petrohi/terminal/README.md

# Geoff's VT100 Terminal

DIY kit including parts and PCB is available on [Tindie](https://www.tindie.com/products/petrohi/geoffs-vt100-terminal-kit/).

## Use PICKit4 to flash the PIC32

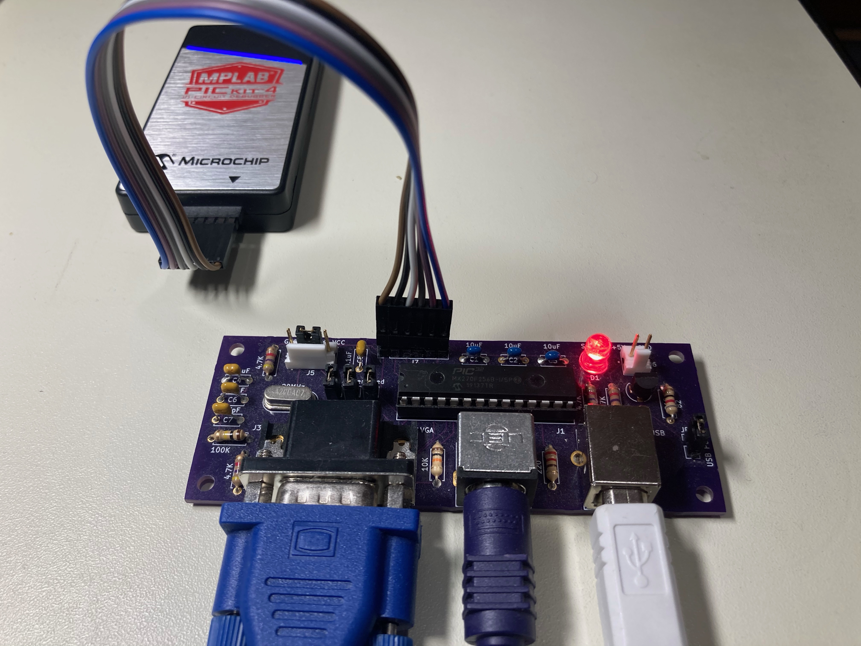
[picture p1: doc/PICKit4.jpeg]
PICKit4


## Use a Raspberry Pi to flash the PIC32

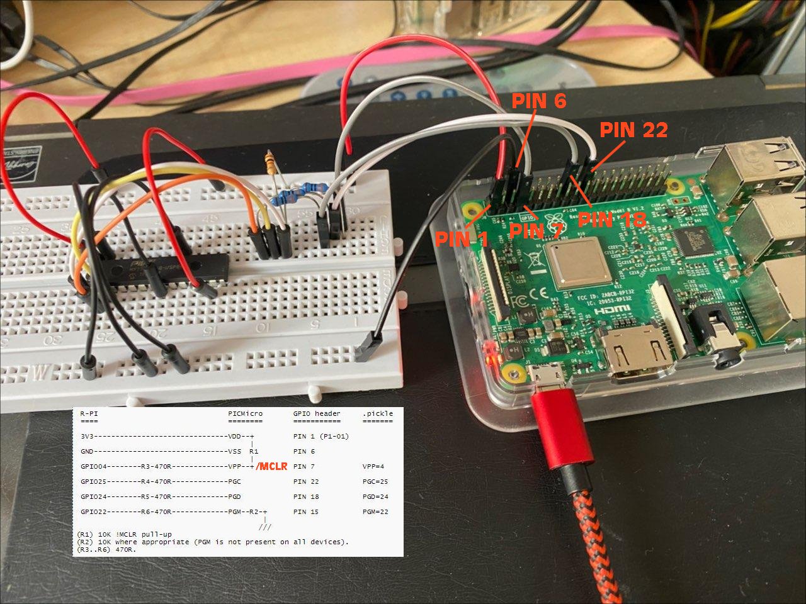
[picture p2: doc/RasberryPi_programmer.jpg]
RasberryPi Programmer


### How to program a PIC Microcontroller using a Raspberry Pi or Orange Pi

* [Pickle](https://www.pedalpc.com/blog/program-pic-raspberry-pi/)
* [Raspberry Pi Setup](https://wiki.kewl.org/dokuwiki/boards:rpi)
