petrohi/terminal/doc/terminal_packing_list.odt

Packing List

| 2 layer PCB
| PIC32MX270F256B-I/SP-ND microcontroller preprogrammed with firmware
| MCP1700-3302E/TO-ND voltage regulator
| Red LED
| 20MHz Crystal
| Sobertone GT-0603A-2 Buzzer
| Ceramic Capacitors 27pF 50V (2)
| Ceramic Capacitors 0.1uF 50V (2)
| Ceramic Capacitors 10uF 16V (3)
| Resistor 82Ω
| Resistor 220Ω
| Resistors 4.7KΩ (4)
| Resistor 10KΩ
| Resistor 100KΩ
| USB B Type Socket
| DE-15 Female Connector
| 6 Pin Mini DIN Female Connector
| 4 way Header Connector
| 2 way Header Connector
| DIP socket
| Header Pins (16)
| Jumpers (4)
