petrohi/terminal/doc/BOM.md

# BOM

| Qty | Component | Digi-Key Part # |
|--|--|--|
| 1 | 2 layer PCB | |
| 1 | PIC32MX270F256B-I/SP-ND microcontroller | [PIC32MX270F256B-I/SP-ND](https://www.digikey.com/en/products/detail/microchip-technology/PIC32MX270F256B-I-SP/4902630) |
| 1 | MCP1700-3302E/TO-ND voltage regulator | [MCP1700-3302E/TO-ND](https://www.digikey.com/en/products/detail/microchip-technology/MCP1700-3302E-TO/652680) |
| 1 | Red LED | [C503B-RAN-CZ0C0AA2CT-ND](https://www.digikey.com/en/products/detail/creeled-inc/C503B-RAN-CZ0C0AA2/6561762) |
| 1 | 20MHz Crystal | [535-9046-ND](https://www.digikey.com/en/products/detail/abracon-llc/ABL-20-000MHZ-B2/675241) |
| 1 | Sobertone GT-0603A-2 Buzzer | [433-1193-ND](https://www.digikey.com/en/products/detail/soberton-inc/GT-0603A-2/8600790) |
| 2 | Ceramic Capacitors 27pF 50V | [BC1006CT-ND](https://www.digikey.com/en/products/detail/vishay-beyschlag-draloric-bc-components/K270J15C0GF5TL2/286460) |
| 2 | Ceramic Capacitors 0.1uF 50V | [BC1084CT-ND](https://www.digikey.com/en/products/detail/vishay-beyschlag-draloric-bc-components/K104K15X7RF5TL2/286538) |
| 3 | Ceramic Capacitors 10uF 16V | [445-FK24X5R1C106KR000-ND](https://www.digikey.com/en/products/detail/tdk-corporation/FK24X5R1C106KR000/2815427) |
| 1 | Resistor 82Ω | [CF14JT82R0CT-ND](https://www.digikey.com/en/products/detail/stackpole-electronics-inc/CF14JT82R0/1741513) |
| 1 | Resistor 220Ω | [CF14JT220RCT-ND](https://www.digikey.com/en/products/detail/stackpole-electronics-inc/CF14JT220R/1741346) |
| 4 | Resistors 4.7KΩ (4) | [CF14JT4K70CT-ND](https://www.digikey.com/en/products/detail/stackpole-electronics-inc/CF14JT4K70/1741428) |
| 1 | Resistor 10KΩ | [CF14JT10K0CT-ND](https://www.digikey.com/en/products/detail/stackpole-electronics-inc/CF14JT10K0/1741265) |
| 1 | Resistor 100KΩ | [CF14JT100KCT-ND](https://www.digikey.com/en/products/detail/stackpole-electronics-inc/CF14JT100K/1741263) |
| 1 | USB B Type Socket | [102-5888-ND](https://www.digikey.com/en/products/detail/cui-devices/UJ2-BH-W4-TH/6188078) |
| 1 | DE-15 Female Connector | [L77HDE15SD1CH4F-ND](https://www.digikey.com/en/products/detail/amphenol-cs-commercial-products/L77HDE15SD1CH4F/4888523) |
| 1 | 6 Pin Mini DIN Female Connector | [CP-2260-ND](https://www.digikey.com/en/products/detail/cui-devices/MD-60SM/96940) |
| 1 | 4 way Header Connector | [A30788-ND](https://www.digikey.com/en/products/detail/te-connectivity-amp-connectors/3-641215-4/765872) |
| 1 | 2 way Header Connector | [A24932-ND](https://www.digikey.com/en/products/detail/te-connectivity-amp-connectors/641215-2/331087) |
| 1 | DIP socket | [ED3050-5-ND](https://www.digikey.com/en/products/detail/on-shore-technology-inc/ED281DT/4147600) |
| 16 | Header Pins | [S1011EC-32-ND](https://www.digikey.com/en/products/detail/sullins-connector-solutions/PRPC032SAAN-RC/2775222) |
| 4 | Jumpers | [S9337-ND](https://www.digikey.com/en/products/detail/sullins-connector-solutions/QPC02SXGN-RC/2618262) |
