petrohi/terminal/case/Cover1.stl

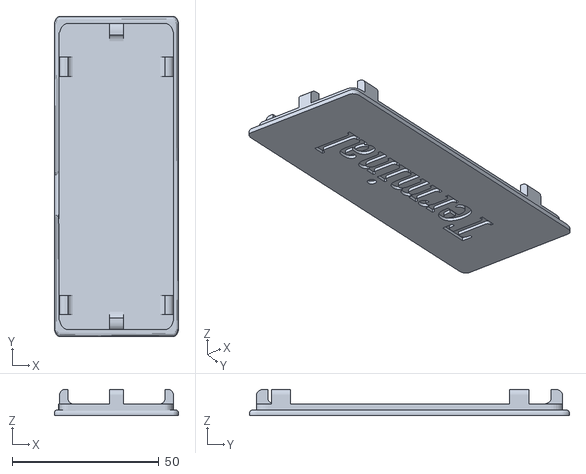
[picture p3: CAD file, 2020-11-10]
case/Cover1.stl
42.3 x 109.0 x 9.00
