petrohi/terminal/kicad/terminal/3d/CUI_MD-60SM.step

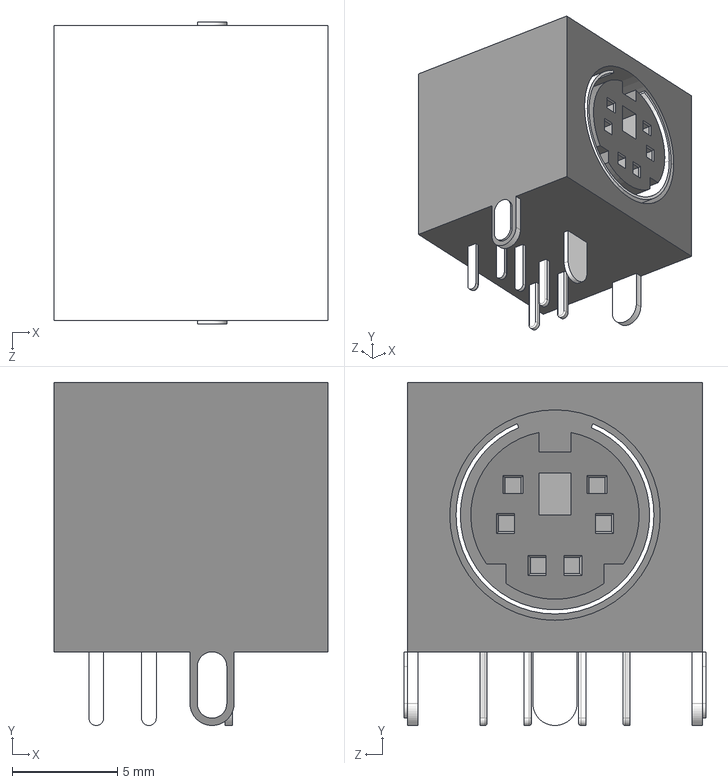
[picture p5: CAD file, 2019-12-02]
kicad/terminal/3d/CUI_MD-60SM.step
13.0 x 16.3 x 14.3 mm
