petrohi/terminal/case/Terminal Box.stl

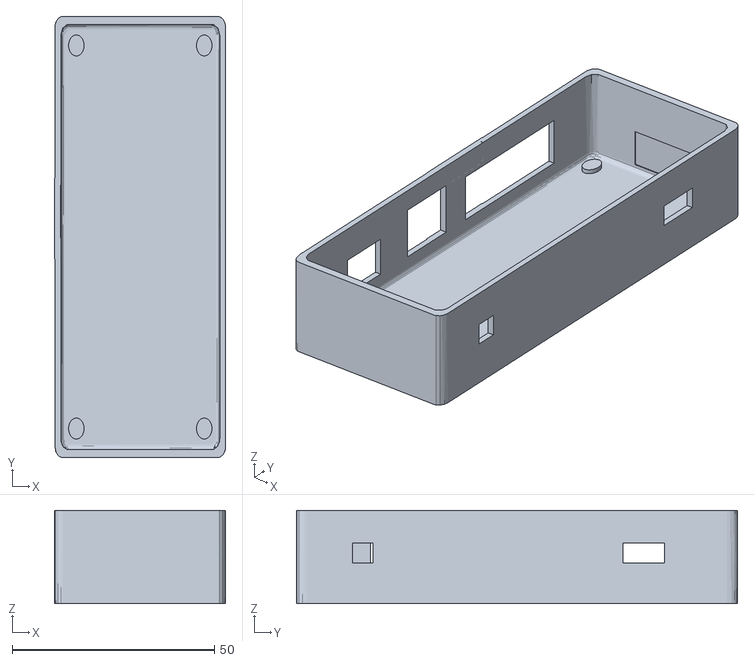
[picture p6: CAD file, 2020-11-10]
case/Terminal Box.stl
42.3 x 109.0 x 23.0
