petrohi/terminal/kicad/terminal/3d/c-3-641215-2-z-3d.stp

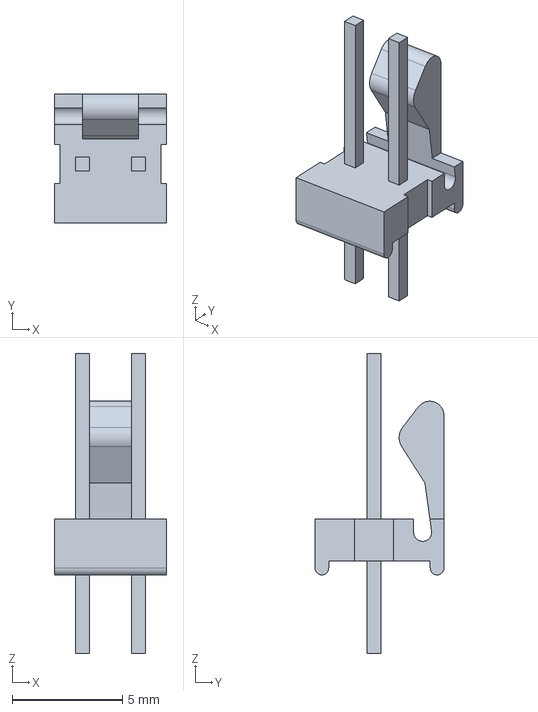
[picture p7: CAD file, 2019-12-02]
kicad/terminal/3d/c-3-641215-2-z-3d.stp
5.08 x 5.84 x 13.6 mm
