petrohi/terminal/(list of files, cad)

Other CAD files:
case/Cover2.stl
