petrohi/terminal/(threads)

Thread 23 (2021-05-25):

usb keyboard

bkw777, 2021-05-25:
Is it at all possible to incorporate @dhansel 's usb keyboard change?
https://github.com/dhansel/TerminalUSB

I have made a pcb that started like yours, dropped the PS/2 port, switched the usb port to type B, added a barrel power jack, and optimized the traces a little.
https://github.com/bkw777/Geoff_vt100
...in hopes I could maybe figure out the differences dhansel made to the original Geoff firmware, and then apply them to yours, which I have not done.

Thread 36 (2023-03-14):

Can we convert an original Geoff Graham ASCII Video Terminal to use this firmware?

BRFud, 2023-03-14:
Hi, and thanks for creating this project. I have a an original Geoff Graham ASCII Video Terminal (originally purchased from Silicon Chip magazine) and would like to know what steps are needed to modify my unit to support this firmware? Do you know if it is possible and could you give me a start by listing the hardware modifications required? Geoff's website lists only that it uses a different crystal, though I notice you have also added a buzzer. Is there anything else? Thank you.

BRFud, 2023-03-24:
closing as I have now recieved some boards to build the terminal version in this repo.

Closed 2023-03-24.

Thread 37 (2023-12-12):

IRQ

Wawavoun, 2023-12-12:
Hi,

On some multitasking system the irq pin of the serial interface chip (MC6850 fe) need to be used.
Polling is not an option.

On MC6850 this pin only works if a kind of flow control (rts/cts) is activated.

The serial link to your terminal has not this option.
Of course this will need to change destination of two pins but may be it is possible to disable some functions (buzzer ?) to get this.

May be in a future version ?

Thanks and regards.
Philippe

Thread 38 (2024-02-14):

PS/2 to USB adapter leads to PS/2 Keyboard not detected

oilcan-productions, 2024-02-14:
I ordered these https://a.co/d/gUzlF0a to hook up a USB keyboard to the VT 100.
Unfortunately it seems it is not detecting the keyboard I use https://a.co/d/cD3fbKI or any other USB keyboard for that matter.

Anything I can do to help with that?

sswazey, 2024-11-22:
Sorry that device won't work.  It's a passive device that just converts the connection.  It expects an older USB keyboard that has legacy PS/2 mode.  The older USB keyboard detects that USB is not connected and then switches to the PS/2 signals.  Almost all of the modern USB keyboards have abandoned PS/2 compatibility mode.
