petrohi/terminal/doc/schematic.pdf

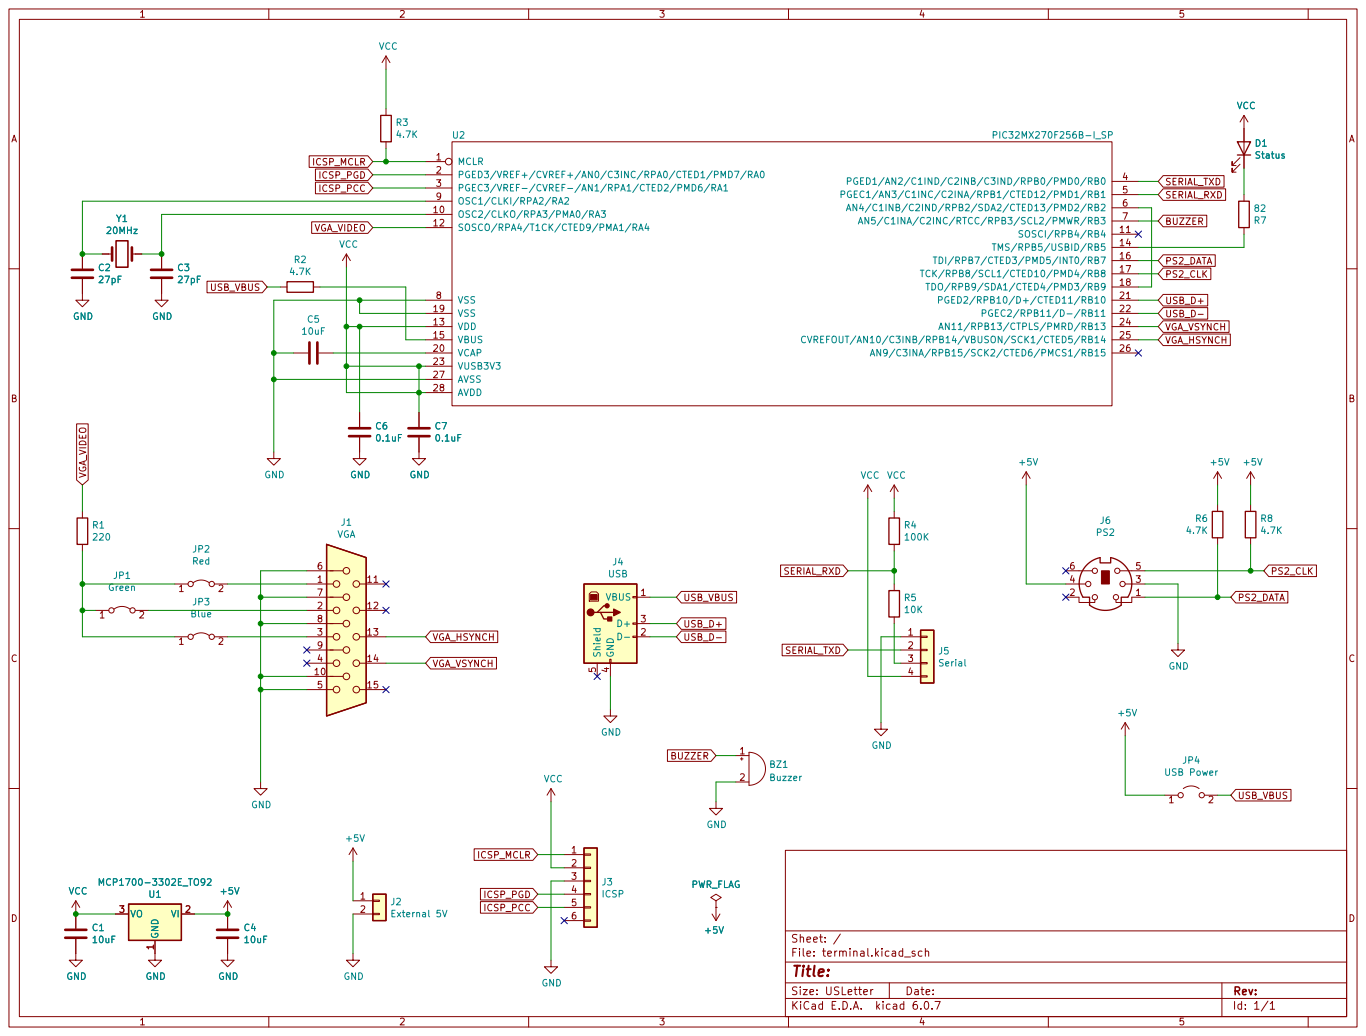
[picture p8: page 1]

1 VI 2 VO 3 U1 MCP1700-3302E_TO92 VCC GND
