petrohi/terminal/firmware/Terminal.X/terminal.c

#include "terminal_internal.h"

#define PRODUCT_NAME                                                           \
  "\33[1;91mA\33[92mS\33[93mC\33[94mI\33[95mI\33[39m Terminal\33[m\r\n"
#define PRODUCT_VERSION "Version 3.2.0\r\n"
#ifdef TERMINAL_8BIT_COLOR
#define PRODUCT_COPYRIGHT                                                      \
  "Copyright (C) 2019-2020 Peter Hizalev\r\n"                                  \
  "https://github.com/petrohi/ascii_terminal\r\n"
#else
#define PRODUCT_COPYRIGHT                                                      \
  "Copyright (C) 2019-2022 Peter Hizalev\r\n"                                  \
  "Copyright (C) 2014 Geoff Graham\r\n"                                        \
  "Copyright (C) 2020 Birko Bergt (DL8BB)\r\n"                                 \
  "Copyright (C) 2021 Stefan \"Blixten\" Karlsson\r\n"                         \
  "https://github.com/petrohi/terminal\r\n"
#endif
#define PRODUCT_HELP "\r\nPress CTRL+ALT+DEL to enter SETUP\r\n"

void terminal_timer_tick(struct terminal *terminal) {
  terminal_keyboard_update_repeat_counter(terminal);
  terminal_screen_update_cursor_counter(terminal);
  terminal_screen_update_blink_counter(terminal);
}

void terminal_init(struct terminal *terminal,
                   const struct terminal_callbacks *callbacks,
                   struct visual_cell *default_cells,
#ifdef TERMINAL_ALT_CELLS
                   struct visual_cell *alt_cells,
#endif
                   uint8_t *tab_stops, size_t tab_stops_size,
                   const volatile struct terminal_config *config,
                   character_t *transmit_buffer, size_t transmit_buffer_size) {
  terminal->callbacks = callbacks;
  terminal->default_cells = default_cells;
#ifdef TERMINAL_ALT_CELLS
  terminal->alt_cells = alt_cells;
#endif
  terminal->tab_stops = tab_stops;
  terminal->tab_stops_size = tab_stops_size;

  switch (config->format_rows) {
  case FORMAT_24_ROWS:
    terminal->format.rows = 24;
    break;
  case FORMAT_30_ROWS:
    terminal->format.rows = 30;
    break;
  }

  terminal->format.cols = 80;
#ifndef TERMINAL_8BIT_COLOR
  terminal->monochrome_transform = config->monochrome_transform;
#endif
  terminal->transmit_buffer = transmit_buffer;
  terminal->transmit_buffer_size = transmit_buffer_size;
  terminal->transmit_buffer_head = 0;

  terminal->charset = config->charset;
  terminal->keyboard_compatibility = config->keyboard_compatibility;
  terminal->receive_c1_mode = config->receive_c1_mode;
  terminal->transmit_c1_mode = config->transmit_c1_mode;

  terminal->auto_wrap_mode = config->auto_wrap_mode;
  terminal->scrolling_mode = false;
  terminal->column_mode = false;
  terminal->screen_mode = config->screen_mode;
  terminal->origin_mode = false;
  terminal->insert_mode = false;

  terminal->send_receive_mode = config->send_receive_mode;

  terminal->new_line_mode = config->new_line_mode;
  terminal->cursor_key_mode = config->cursor_key_mode;
  terminal->keyboard_action_mode = false;
  terminal->auto_repeat_mode = config->auto_repeat_mode;
  terminal->ansi_mode = config->ansi_mode;
  terminal->backspace_mode = config->backspace_mode;

  terminal->flow_control = config->flow_control;
  terminal->bell_buzzer = config->bell_buzzer;

  terminal->lock_state.caps = 0;
  terminal->lock_state.scroll = 0;
  terminal->lock_state.num = config->application_keypad_mode ? 0 : 1;

  terminal_keyboard_init(terminal, config->keyboard_layout);
  terminal_screen_init(terminal);
  terminal_uart_init(terminal);

  terminal->saved_vs = terminal->vs;

  switch (config->start_up) {
  case START_UP_NONE:
    break;
  case START_UP_MESSAGE:
    terminal_uart_receive_string(
        terminal,
        PRODUCT_NAME PRODUCT_VERSION PRODUCT_COPYRIGHT PRODUCT_HELP "\r\n");
    break;
#ifdef TERMINAL_8BIT_COLOR
  case START_UP_TEST_COLOR1:
    terminal->callbacks->screen_test(terminal->format, SCREEN_TEST_COLOR1);
    break;
  case START_UP_TEST_COLOR2:
    terminal->callbacks->screen_test(terminal->format, SCREEN_TEST_COLOR2);
    break;
#endif
  case START_UP_TEST_FONT1:
    terminal->callbacks->screen_test(terminal->format, SCREEN_TEST_FONT1);
    break;
  case START_UP_TEST_FONT2:
    terminal->callbacks->screen_test(terminal->format, SCREEN_TEST_FONT2);
    break;
  }

  terminal_uart_receive_string(terminal, "\x07");
}
