petrohi/terminal/firmware/Terminal.X/bold.h

/* row data, big-endian (smallest bit on right) */

const int bold_font_glyphs = 1199;
const int bold_font_height = 16;

const uint8_t bold_font_data[19184] = {
  0x00, 0x00, 0xee, 0xc6, 0x00, 0xc6, 0xc6, 0xc6, 0x00, 0xc6, 0xc6, 0xee, 0x00, 0x00, 0x00, 0x00, 
  0x00, 0x00, 0x00, 0x00, 0x00, 0x00, 0x00, 0x00, 0x00, 0x00, 0x00, 0x00, 0x00, 0x00, 0x00, 0x00, 
  0x00, 0x00, 0x18, 0x18, 0x18, 0x18, 0x18, 0x18, 0x18, 0x00, 0x18, 0x18, 0x00, 0x00, 0x00, 0x00, 
  0x00, 0x66, 0x66, 0x66, 0x00, 0x00, 0x00, 0x00, 0x00, 0x00, 0x00, 0x00, 0x00, 0x00, 0x00, 0x00, 
  0x00, 0x00, 0x6c, 0x6c, 0x6c, 0xfe, 0x6c, 0x6c, 0xfe, 0x6c, 0x6c, 0x6c, 0x00, 0x00, 0x00, 0x00, 
  0x00, 0x10, 0x10, 0x7c, 0xd6, 0xd0, 0xd0, 0x7c, 0x16, 0x16, 0xd6, 0x7c, 0x10, 0x10, 0x00, 0x00, /* 5 */
  0x00, 0x00, 0x66, 0xd6, 0x6c, 0x0c, 0x18, 0x18, 0x30, 0x36, 0x6b, 0x66, 0x00, 0x00, 0x00, 0x00, 
  0x00, 0x00, 0x38, 0x6c, 0x6c, 0x38, 0x76, 0xdc, 0xcc, 0xcc, 0xdc, 0x76, 0x00, 0x00, 0x00, 0x00, 
  0x00, 0x18, 0x18, 0x18, 0x00, 0x00, 0x00, 0x00, 0x00, 0x00, 0x00, 0x00, 0x00, 0x00, 0x00, 0x00, 
  0x00, 0x00, 0x0c, 0x18, 0x30, 0x30, 0x30, 0x30, 0x30, 0x30, 0x18, 0x0c, 0x00, 0x00, 0x00, 0x00, 
  0x00, 0x00, 0x30, 0x18, 0x0c, 0x0c, 0x0c, 0x0c, 0x0c, 0x0c, 0x18, 0x30, 0x00, 0x00, 0x00, 0x00, /* 10 */
  0x00, 0x00, 0x00, 0x00, 0x00, 0x6c, 0x38, 0xfe, 0x38, 0x6c, 0x00, 0x00, 0x00, 0x00, 0x00, 0x00, 
  0x00, 0x00, 0x00, 0x00, 0x00, 0x18, 0x18, 0x7e, 0x18, 0x18, 0x00, 0x00, 0x00, 0x00, 0x00, 0x00, 
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
, 1065, 1066, 1067, 1068, 1069, 1070, 1071, 1072, 1073, 1074, 1075, 1076, 1077, 1078, 1079, 1080, 1081, 1082, 1083, 1084, 1085, 1086, 1087, 1088, 1089, 1090, 1091, 1092, 1093, 1094, 1095, 1096, 1097, 1098, 1099, 1100, 1101, 1102, 1103, 1104, 1105, 1106, 1107, 1108, 1109, 1110, 1111, 1112, 1113, 1114, 1115, 1116, 1117, 1118, 1119, 1120, 1121, 1122, 1123, 1124, 1125, 1126, 1127, 1128, 1129, 1130, 1131, 1132, 1133, 1134, 1135, 1136, 1137, 1138, 1139, 1140, 1141, 1142, 1143, 1144, 1145, 1146, 1147, 1148, 1149, 1150, 1151, 1152, 1153, 1154, 1155, 1156, 1157, 1158, 1159, 1160, 1161, 1162, 1163, 1164, 1165, 1166, 1167, 1168, 1169, 1170, 1171, 1172, 1173, 1174, 1175, 1176, 1177, 1178, 1179, 1180, 1181, 1182, 1183, 1184, 1185, 1186, 1187, 1188, 1189, 1190, 1191, 1192, 1193, 1194, 1195, 1196, 1197, 351, 1198 };
