petrohi/terminal/firmware/Terminal.X/luminance_table.h

#define LUMNINANCE_TABLE_SIZE 256

static const uint8_t luminance_table[LUMNINANCE_TABLE_SIZE] = {
  0,
  27,
  91,
  118,
  9,
  36,
  100,
  192,
  128,
  54,
  182,
  236,
  18,
  72,
  200,
  254,
  0,
  6,
  9,
  12,
  15,
  18,
  67,
  74,
  77,
  80,
  83,
  86,
  96,
  103,
  106,
  109,
  112,
  114,
  125,
  132,
  134,
  137,
  140,
  143,
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
};
