petrohi/terminal/(commit log)

2019-10-13 KiCad files
    [terminal.kicad_pcb, terminal.sch]
2019-10-16 Move KiCad files
    [terminal.kicad_pcb, terminal.sch]
2019-10-30 Use oval holes instead of cuts in footprints. Remove bootload jumper.
    [terminal.kicad_pcb, terminal.sch]
2019-12-02 Vga (#1)
    * VGA firmware
    * VGA hardware
    * Fix serial pin marks
    * Remove old video
    * 3D models
    * Adjust copyright notes
    * Move and rename VGA constants
    * Adjust name in prompt
    * VT escape commands
    * HS mode for primary oscillator
    * Enlarge serial and USB buffers
    * Simple graphics
    * 20MHz crystal to support USB
    * Adjust USB and serial buffers
    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
    [CUI_MD-60SM.step, c-3-641215-2-z-3d.stp, c-3-641215-4-z-3d.stp, terminal.kicad_pcb, terminal.sch]
2020-09-24 Port version 3 firmware (#15)
    * Port version 3 firmware
    * Convert PS/2 scancode to USB HID info
    * Simplified VGA driver
    * One DMA transfer per frame
    * Byte-aligned VGA buffer
    * Monochrome configuration
    * Constant luminance table
    * Yield to probe keyboard
    * Fix keyboard LEDs
    * Clear screen line for monochrome
    * Use local buffer for echo mode
    * Fix SD/SU
    * Probe keyboard when in config UI
    * Optimize character rendering
    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
    [terminal.kicad_pcb, terminal.sch]
2020-11-10 Added a 3d printable case
    [Cover1.stl, Cover2.stl, Terminal Box.stl]
2020-11-10 Fixed stupid naming problem
    [Cover1.stl, Terminal Box.stl]
2021-05-11 Fix "warning: Interrupt priority IPLx is deprecated"
    [keyboard.c, main.c]
2021-11-21 Fix default tab positions to match VT100 Technical Manual, Third Edition, July 1982
    [terminal_screen.c]
2021-12-14 Fix for buffer head changing while receiving in the main loop
    [main.c]
2021-12-25 Fix missing key press
    [keyboard.c]
2022-06-07 Improved PCB
    [terminal.kicad_pcb, terminal.kicad_sch, terminal.sch]
2022-06-07 Remove volatile const workaround
    [main.c]
2022-12-15 PWM signal for Sobertone GT-0603A-2
2022-12-15 Buzzer in schematics and PCB
    [terminal.kicad_pcb, terminal.kicad_sch]
2022-12-15 Adjust footprint for 0.1uF and 27pF capacitors
    [terminal.kicad_pcb, terminal.kicad_sch]
2022-12-15 Adjust plot settings
    [terminal.kicad_pcb]
2022-12-15 Add schematic.pdf
2026-04-14 BOM (#35)
